KimiakiK/EB-RH850F1KMS1-hard/EB-RH850F1KMS1.pdf

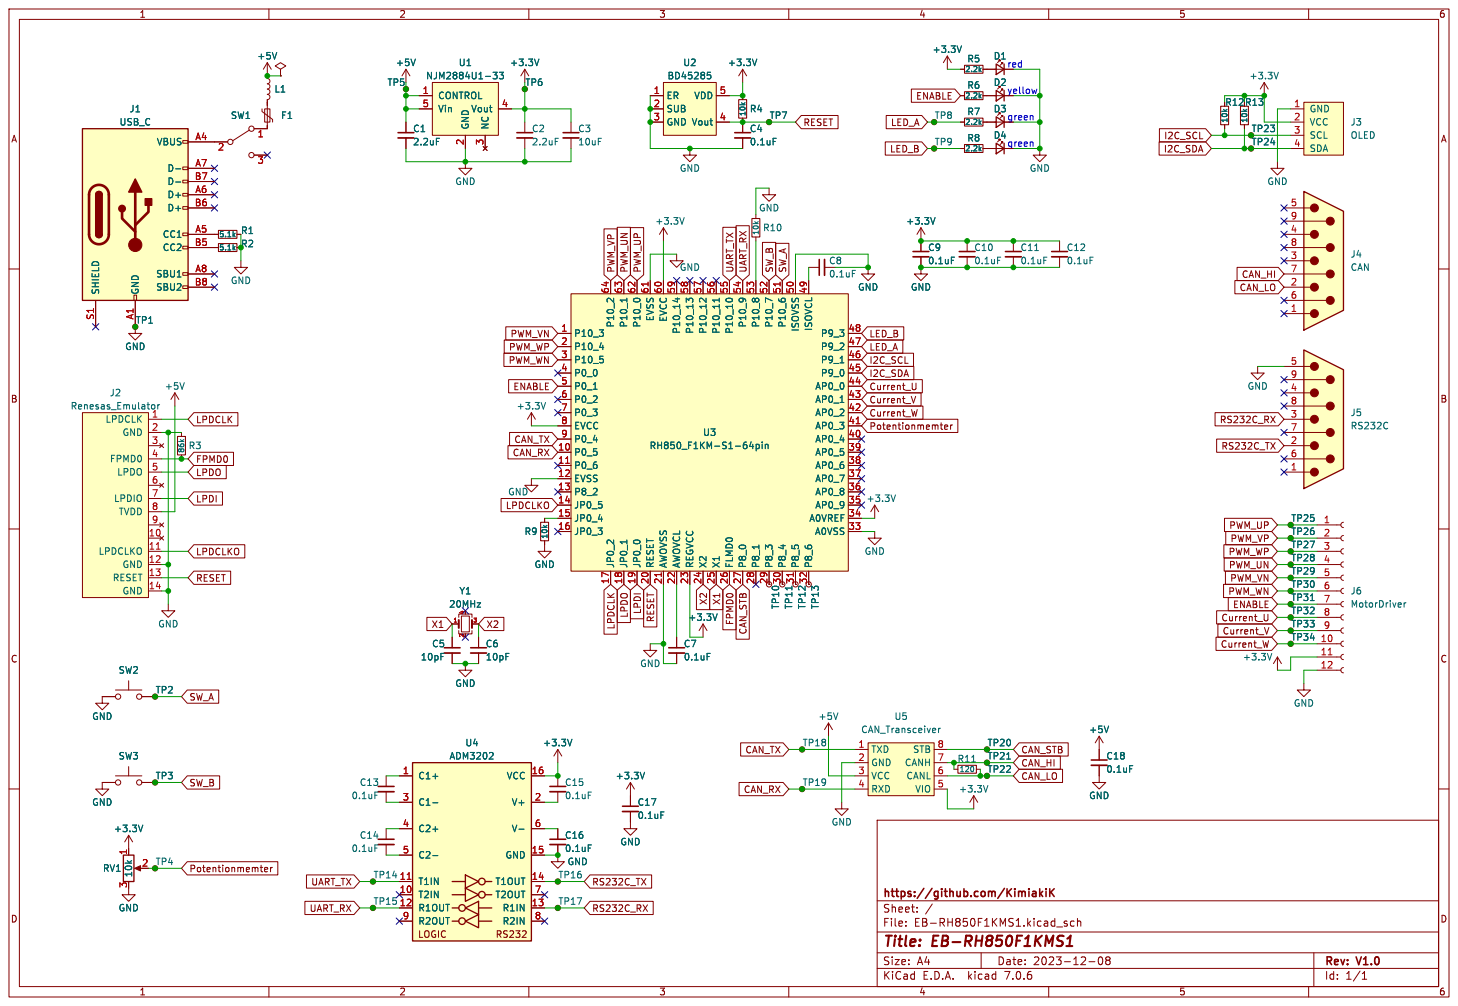
[picture p1: page 1]

GND 1 VCC 2 SCL 3 SDA 4

TP2 GND
LPDCLKO 11 GND 12 RESET 13 GND 14 GND 2
3 FPMD0 4

File: EB-RH850F1KMS1.kicad_sch Sheet: / https://github.com/KimiakiK
