KimiakiK/EB-RH850F1KMS1-hard/EB-RH850F1KMS1.kicad_pcb

## KiCad design EB-RH850F1KMS1.kicad_pcb (2023-12-17)

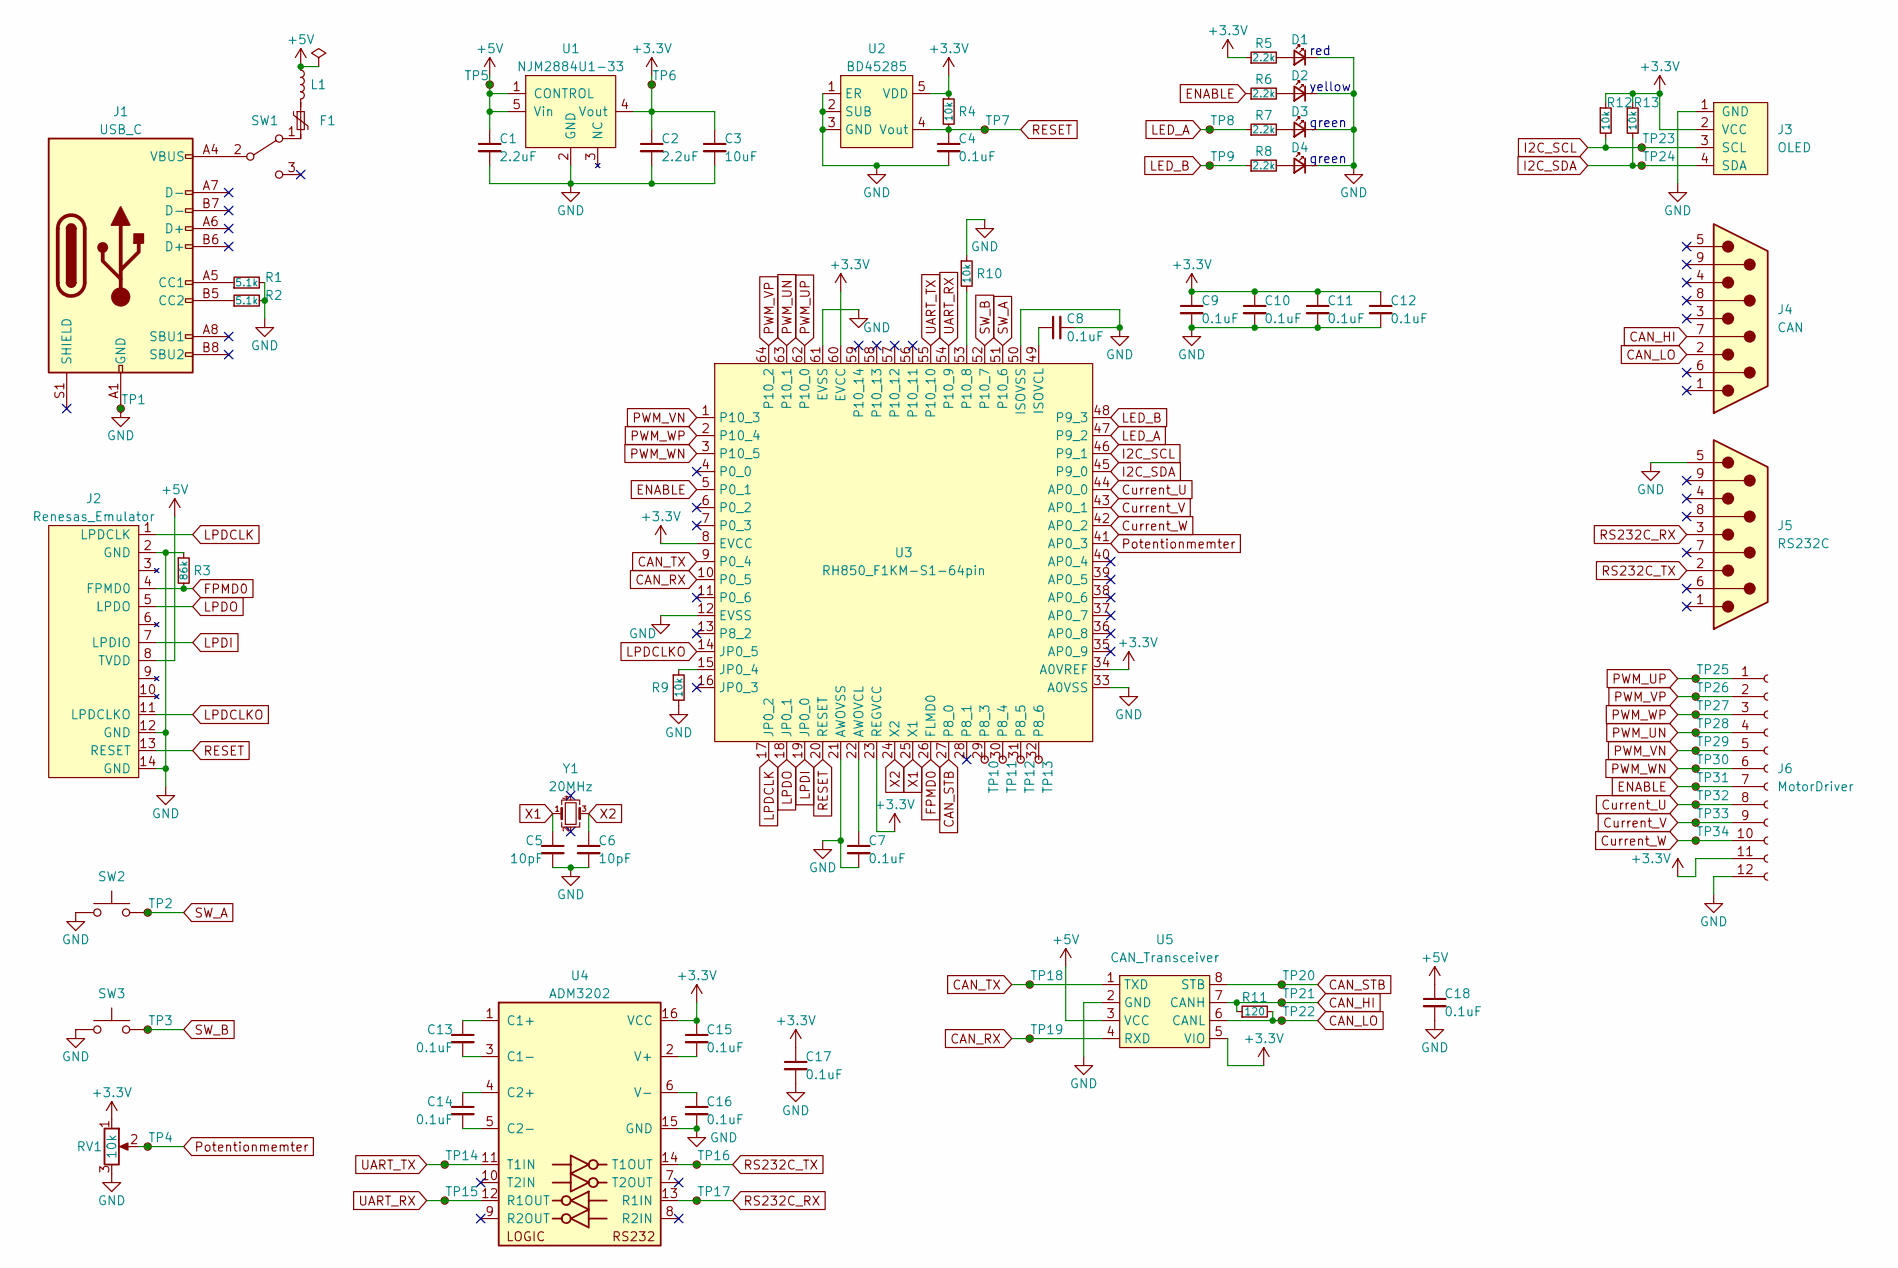
[picture p2: schematic EB-RH850F1KMS1.kicad_sch]

Parts:
C1, C2: 2.2uF; 1608Metric
C3: 10uF; 1608Metric
C4, C7, C8, C9, C10, C11, C12, C13, C14, C15, C16, C17, C18: 0.1uF; 1608Metric
C5, C6: 10pF; 1005Metric
D1, D2, D3, D4: LED; 1608Metric
F1: Polyfuse; 1608Metric
J1: USB_C; USB Type-C 5077CR-16SMC2-BK-TR
J2: Renesas_Emulator; IDC-Header_2x07_P2.54mm_Vertical
J3: OLED; OLED_128x64
J4: CAN; DSUB-9_Male_Horizontal_P2.77x2.84mm_EdgePinOffset7.70mm_Hou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
J5: RS232C; DSUB-9_Male_Horizontal_P2.77x2.84mm_EdgePinOffset7.70mm_Hou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
J6: MotorDriver; PinSocket_2x06_P2.54mm_Horizontal
L1: L; 1608Metric
R1, R2: 5.1k; 1608Metric
R3: 86k; 1608Metric
R4, R9, R10, R12, R13: 10k; 1608Metric
R5, R6, R7, R8: 2.2k; 1608Metric
R11: 120; 1608Metric
RV1: 10k; Potentiometer_Alps_RK097_Dual_Horizontal
SW1: SW_SPDT; Toggle_Switch
SW2, SW3: SW_Push; SW_TVAF06
TP1, TP2, TP3, TP4, TP5, TP6, TP7, TP8, TP9, TP10, TP11, TP12, TP13, TP14, TP15, TP16, TP17, TP18, TP19, TP20, TP21, TP22, TP23, TP24, TP25, TP26, TP27, TP28, TP29, TP30, TP31, TP32, TP33, TP34: TestPoint; TestPoint_Plated_Hole_D0.8mm
U1: NJM2884U1-33; SOT-89-5
U2: BD45285; SOT-23-5
U3: RH850_F1KM-S1-64pin; LQFP-64_10x10mm_P0.5mm
U4: ADM3202; TSSOP-16-1EP_4.4x5mm_P0.65mm
U5: CAN_Transceiver; DIP-8_W7.62mm_Socket
Y1: 20MHz; Crystal_SMD_3225-4Pin_3.2x2.5mm

Connections:
+3.3V: C2.1, C3.1, C9.1, C10.1, C11.1, C12.1, C15.1, C17.1, J3.2 (VCC), J6.11, R4.1, R5.1, R12.1, R13.1, RV1.1, TP6.1, U1.4 (Vout), U2.5 (VDD), U3.8 (EVCC), U3.23 (REGVCC), U3.34 (A0VREF), U3.60 (EVCC), U4.16 (VCC), U5.5 (VIO)
+5V: C1.1, C18.1, J2.8 (TVDD), L1.1, TP5.1, U1.1 (CONTROL), U1.5 (Vin), U5.3 (VCC)
CAN_HI: J4.7, R11.1, TP21.1, U5.7 (CANH)
CAN_LO: J4.2, R11.2, TP22.1, U5.6 (CANL)
CAN_RX: TP19.1, U3.10 (P0_5), U5.4 (RXD)
CAN_STB: TP20.1, U3.27 (P8_0), U5.8 (STB)
CAN_TX: TP18.1, U3.9 (P0_4), U5.1 (TXD)
Current_U: J6.8, TP32.1, U3.44 (AP0_0)
Current_V: J6.9, TP33.1, U3.43 (AP0_1)
Current_W: J6.10, TP34.1, U3.42 (AP0_2)
ENABLE: J6.7, R6.1, TP31.1, U3.5 (P0_1)
FPMD0: J2.4 (FPMD0), R3.2, U3.26 (FLMD0)
GND: C1.2, C2.2, C3.2, C4.2, C5.2, C6.2, C7.2, C8.2, C9.2, C10.2, C11.2, C12.2, C16.2, C17.2, C18.2, D1.1 (K), D2.1 (K), D3.1 (K), D4.1 (K), J1.A1 (GND), J1.A12 (GND), J1.B1 (GND), J1.B12 (GND), J2.2 (GND), J2.12 (GND), J2.14 (GND), J3.1 (GND), J5.5, J6.12, R1.2, R2.2, R3.1, R9.2, R10.1, RV1.3, SW2.1, SW3.1, TP1.1, U1.2 (GND), U2.1 (ER), U2.2 (SUB), U2.3 (GND), U3.12 (EVSS), U3.21 (AWOVSS), U3.33 (A0VSS), U3.50 (ISOVSS), U3.61 (EVSS), U4.15 (GND), U5.2 (GND)
I2C_SCL: J3.3 (SCL), R12.2, TP23.1, U3.46 (P9_1)
I2C_SDA: J3.4 (SDA), R13.2, TP24.1, U3.45 (P9_0)
LED_A: R7.1, TP8.1, U3.47 (P9_2)
LED_B: R8.1, TP9.1, U3.48 (P9_3)
LPDCLK: J2.1 (LPDCLK), U3.17 (JP0_2)
LPDCLKO: J2.11 (LPDCLKO), U3.14 (JP0_5)
LPDI: J2.7 (LPDIO), U3.19 (JP0_0)
LPDO: J2.5 (LPDO), U3.18 (JP0_1)
unnamed: D1.2 (A), R5.2
unnamed: D2.2 (A), R6.2
unnamed: D3.2 (A), R7.2
unnamed: D4.2 (A), R8.2
unnamed: F1.1, L1.2
unnamed: J1.A5 (CC1), R1.1
unnamed: J1.B5 (CC2), R2.1
unnamed: F1.2, SW1.1 (A)
unnamed: J1.A4 (VBUS), J1.A9 (VBUS), J1.B4 (VBUS), J1.B9 (VBUS), SW1.2 (B)
unnamed: C7.1, U3.22 (AWOVCL)
unnamed: C8.1, U3.49 (ISOVCL)
unnamed: R9.1, U3.15 (JP0_4)
unnamed: TP10.1, U3.29 (P8_3)
unnamed: TP11.1, U3.30 (P8_4)
unnamed: TP12.1, U3.31 (P8_5)
unnamed: TP13.1, U3.32 (P8_6)
unnamed: R10.2, U3.53 (P10_8)
unnamed: C13.1, U4.1 (C1+)
unnamed: C13.2, U4.3 (C1-)
unnamed: C14.1, U4.4 (C2+)
unnamed: C14.2, U4.5 (C2-)
unnamed: C15.2, U4.2 (V+)
unnamed: C16.1, U4.6 (V-)
PWM_UN: J6.4, TP28.1, U3.63 (P10_1)
PWM_UP: J6.1, TP25.1, U3.62 (P10_0)
PWM_VN: J6.5, TP29.1, U3.1 (P10_3)
PWM_VP: J6.2, TP26.1, U3.64 (P10_2)
PWM_WN: J6.6, TP30.1, U3.3 (P10_5)
PWM_WP: J6.3, TP27.1, U3.2 (P10_4)
Potentionmemter: RV1.2, TP4.1, U3.41 (AP0_3)
RESET: C4.1, J2.13 (RESET), R4.2, TP7.1, U2.4 (Vout), U3.20 (RESET)
RS232C_RX: J5.3, TP17.1, U4.13 (R1IN)
RS232C_TX: J5.2, TP16.1, U4.14 (T1OUT)
SW_A: SW2.2, TP2.1, U3.51 (P10_6)
SW_B: SW3.2, TP3.1, U3.52 (P10_7)
UART_RX: TP15.1, U3.54 (P10_9), U4.12 (R1OUT)
UART_TX: TP14.1, U3.55 (P10_10), U4.11 (T1IN)
X1: C5.1, U3.25 (X1), Y1.1
X2: C6.1, U3.24 (X2), Y1.3

Notes on the sheet:
green
red
yellow

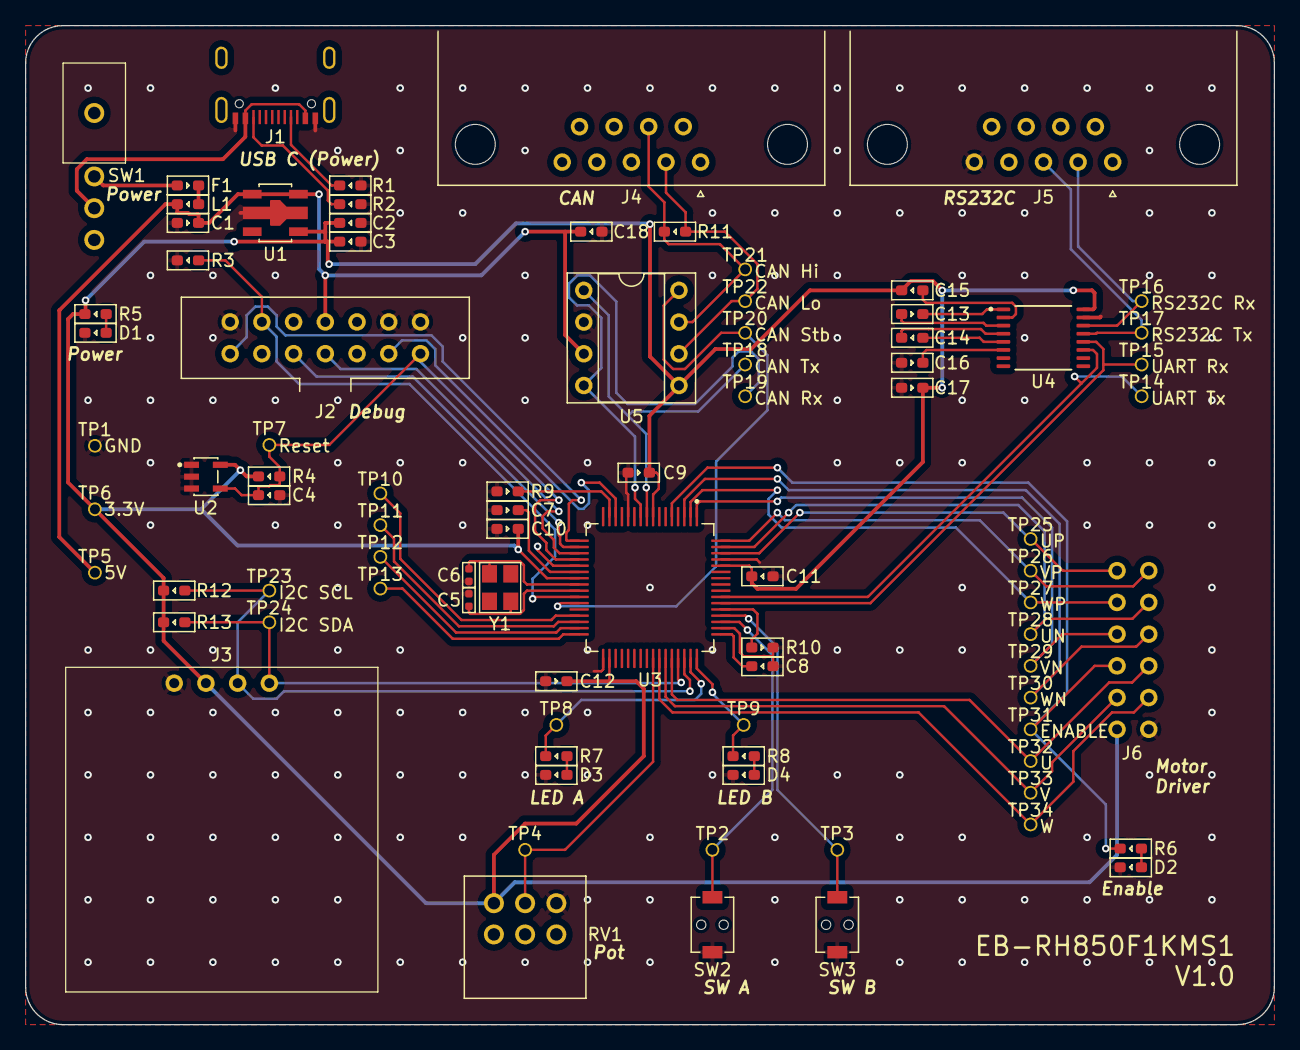
[picture p3: board EB-RH850F1KMS1.kicad_pcb from above]

Board: 2 copper layers, 100.0 x 80.0 mm, 87 parts (0 on the bottom side), 60 nets.
