KimiakiK/EB-RH850F1KMS1-hard/(commit log)

2023-12-17 基板 V1.0
    [EB-RH850F1KMS1-B_Cu.gbl, EB-RH850F1KMS1-B_Mask.gbs, EB-RH850F1KMS1-B_Paste.gbp, EB-RH850F1KMS1-B_Silkscreen.gbo, EB-RH850F1KMS1-Edge_Cuts.gm1, EB-RH850F1KMS1-F_Cu.gtl, EB-RH850F1KMS1-F_Mask.gts, EB-RH850F1KMS1-F_Paste.gtp]
2024-01-11 回路図追加
